matth215/EE256/Final_Project.kicad_sch

## KiCad design Final_Project.kicad_sch (2023-11-02)

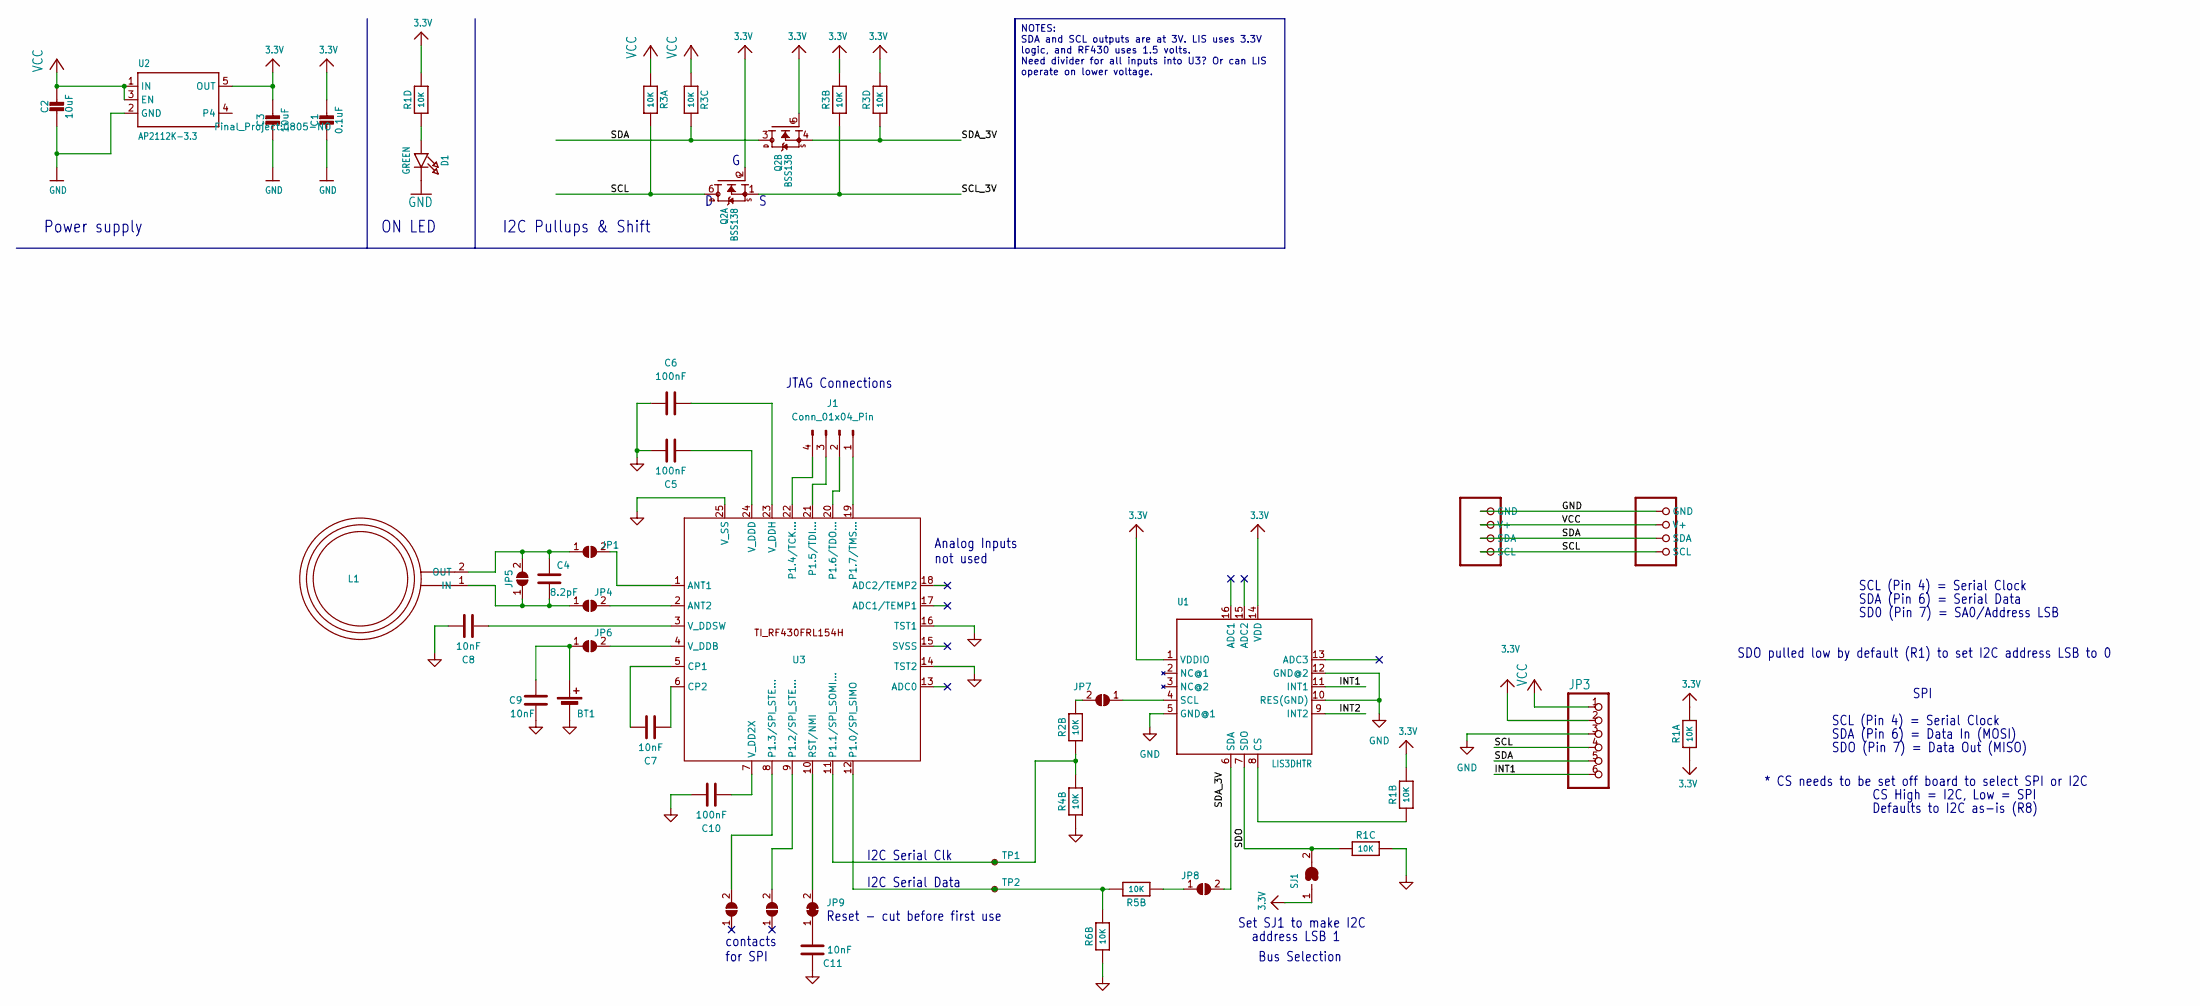
[picture p3: schematic Final_Project.kicad_sch]

Parts:
BT1: Battery_Cell
C1: 0.1uF; 0603-NO
C2, C3: 10uF; 0805-NO
C4: 8.2pF; C_1206_3216Metric_Pad1.33x1.80mm_HandSolder; Mfr P/N CL31A106MAHNNNE
C5, C6, C10: 100nF; C_1206_3216Metric_Pad1.33x1.80mm_HandSolder; Mfr P/N CL31A106MAHNNNE
C7, C8, C9, C11: 10nF; C_1206_3216Metric_Pad1.33x1.80mm_HandSolder; Mfr P/N CL31A106MAHNNNE
CONN3, CONN4: STEMMA_I2C_QT; JST_SH4
D1: GREEN; CHIPLED_0603_NOOUTLINE
J1: Conn_01x04_Pin
JP1, JP4, JP5, JP6, JP7, JP8, JP10, JP11: SolderJumper_2_Open
JP3: HEADER-1X670MIL; 1X06_ROUND_70
JP9: SolderJumper_2_Bridged
L1: (no value)
Q2: BSS138; SOT363
R1, R2, R3, R4, R5, R6: 10K; RESPACK_4X0603
SJ1: SOLDERJUMPER; SOLDERJUMPER_ARROW_NOPASTE
TP1, TP2: TestPoint_Small
U1: LIS3DHTR; LGA16_3X3MM
U2: AP2112K-3.3; SOT23-5
U3: QFN50P400X400X100-25N

Connections:
3.3V: C1.1, C3.1, JP3.2, Q2.2 (G), Q2.5 (G), R1.1, R1.5 (2), R1.7 (2), R1.8 (2), R3.2 (1), R3.4 (1), SJ1.1, U1.1 (VDDIO), U1.14 (VDD), U2.5 (OUT)
GND: BT1.2 (-), C1.2, C2.2, C3.2, C5.2, C6.1, C8.2, C9.1, C10.2, C11.2, CONN3.1 (GND), CONN4.1 (GND), D1.C, JP3.3, R1.6 (2), R4.2 (1), R6.2 (1), U1.5 (GND@1), U1.10 (RES(GND)), U1.12 (GND@2), U2.2 (GND), U3.14 (TST2), U3.16 (TST1), U3.25 (V_SS)
INT1: JP3.6, U1.11 (INT1)
INT2: U1.9 (INT2)
unnamed: BT1.1 (+), C9.2, JP6.1 (A)
unnamed: C4.1, JP1.1 (A), JP5.2 (B), L1.2 (OUT)
unnamed: C4.2, JP4.1 (A), JP5.1 (A), L1.1 (IN)
unnamed: C5.1, U3.24 (V_DDD)
unnamed: C6.2, U3.23 (V_DDH)
unnamed: C7.1, U3.6 (CP2)
unnamed: C7.2, U3.5 (CP1)
unnamed: C8.1, U3.3 (V_DDSW)
unnamed: C10.1, U3.7 (V_DD2X)
unnamed: C11.1, JP9.1 (A)
unnamed: D1.A, R1.4 (1)
unnamed: J1.1, U3.19 (P1.7/TMS...)
unnamed: J1.2, U3.20 (P1.6/TDO...)
unnamed: J1.3, U3.21 (P1.5/TDI...)
unnamed: J1.4, U3.22 (P1.4/TCK...)
unnamed: JP1.2 (B), U3.1 (ANT1)
unnamed: JP4.2 (B), U3.2 (ANT2)
unnamed: JP6.2 (B), U3.4 (V_DDB)
unnamed: JP7.1 (A), U1.4 (SCL)
unnamed: JP7.2 (B), R2.7 (2)
unnamed: JP8.1 (A), R5.2 (1)
unnamed: JP8.2 (B), U1.6 (SDA)
unnamed: JP9.2 (B), U3.10 (RST/NMI)
unnamed: JP10.2 (B), U3.8 (P1.3/SPI_STE...)
unnamed: JP11.2 (B), U3.9 (P1.2/SPI_STE...)
unnamed: R1.2 (1), U1.8 (CS)
unnamed: R2.2 (1), R4.7 (2), TP1.1, U3.11 (P1.1/SPI_SOMI...)
unnamed: R5.7 (2), R6.7 (2), TP2.1, U3.12 (P1.0/SPI_SIMO)
SCL: CONN3.4 (SCL), CONN4.4 (SCL), JP3.4, Q2.6 (D), R3.8 (2)
SCL_3V: Q2.1 (S), R3.7 (2)
SDA: CONN3.3 (SDA), CONN4.3 (SDA), JP3.5, Q2.3 (D), R3.6 (2)
SDA_3V: Q2.4 (S), R3.5 (2)
SDO: R1.3 (1), SJ1.2, U1.7 (SDO)
VCC: C2.1, CONN3.2 (V+), CONN4.2 (V+), JP3.1, R3.1, R3.3 (1), U2.1 (IN), U2.3 (EN)

Notes on the sheet:
NOTES: SDA and SCL outputs are at 3V. LIS uses 3.3V logic, and RF430 uses 1.5 volts. Need divider for all inputs into U3? Or can LIS operate on lower voltage.
JTAG Connections
Analog Inputs not used
Bus Selection
SDO pulled low by default (R1) to set I2C address LSB to 0
SDA (Pin 6) = Data In (MOSI)
SDO (Pin 7) = Data Out (MISO)
* CS needs to be set off board to select SPI or I2C
I2C Pullups & Shift
Defaults to I2C as-is (R8)
SCL (Pin 4) = Serial Clock
ON LED
I2C Serial Data
CS High = I2C, Low = SPI
SDA (Pin 6) = Serial Data
address LSB 1
SD0 (Pin 7) = SA0/Address LSB
Power supply
Set SJ1 to make I2C
Reset - cut before first use
I2C Serial Clk
SPI
contacts for SPI
