matth215/EE256/(commit log)

2023-10-13 Requirements for Embedded Accelerometer
    My first git upload
2023-11-02 Add files via upload
    Version 1 - needs refinement
    [Final_Project.kicad_sch]
